EstufaAutomatica-MTI/MTI_EstufaAutomatica/MTI_EstufaAutomatica.ioc

Mcu.UserName=STM32F446RETx
PA0-WKUP.Signal=ADCx_IN0
PA1.Signal=GPIO_Output
PA13.GPIO_Label=TMS
PA13.Signal=SYS_JTMS-SWDIO
PA14.GPIO_Label=TCK
PA14.Signal=SYS_JTCK-SWCLK
PA15.Signal=S_TIM2_CH1_ETR
PA2.GPIO_Label=USART_TX
PA2.Signal=USART2_TX
PA3.GPIO_Label=USART_RX
PA3.Signal=USART2_RX
PA4.Signal=ADCx_IN4
PA5.GPIO_Label=LD2 [Green Led]
PA5.Signal=GPIO_Output
PA7.Signal=ADCx_IN7
PB3.GPIO_Label=SWO
PB3.Signal=SYS_JTDO-SWO
PB7.GPIO_Label=Shutdown
PB7.Signal=GPIO_Output
PC0.GPIO_Label=WaterPump
PC0.Signal=GPIO_Output
PC1.GPIO_Label=PeltierPlate
PC1.Signal=GPIO_Output
PC13.GPIO_Label=B1 [Blue PushButton]
PC13.Signal=GPXTI13
PC14-OSC32_IN.Signal=RCC_OSC32_IN
PC15-OSC32_OUT.Signal=RCC_OSC32_OUT
PC2.GPIO_Label=CoolerFreeze
PC2.Signal=GPIO_Output
PC3.GPIO_Label=CoolerPeltier
PC3.Signal=GPIO_Output
PC6.GPIO_Label=LedRed
PC6.Signal=S_TIM3_CH1
PC8.GPIO_Label=LedGreen
PC8.Signal=S_TIM3_CH3
PC9.GPIO_Label=LedBlue
PC9.Signal=S_TIM3_CH4
PH0-OSC_IN.Signal=RCC_OSC_IN
PH1-OSC_OUT.Signal=RCC_OSC_OUT
