EstufaAutomatica-MTI/MTI_EstufaAutomatica/Core/Inc/main.h

#define B1_Pin GPIO_PIN_13
#define B1_GPIO_Port GPIOC
#define WaterPump_Pin GPIO_PIN_0
#define WaterPump_GPIO_Port GPIOC
#define PeltierPlate_Pin GPIO_PIN_1
#define PeltierPlate_GPIO_Port GPIOC
#define CoolerFreeze_Pin GPIO_PIN_2
#define CoolerFreeze_GPIO_Port GPIOC
#define CoolerPeltier_Pin GPIO_PIN_3
#define CoolerPeltier_GPIO_Port GPIOC
#define USART_TX_Pin GPIO_PIN_2
#define USART_TX_GPIO_Port GPIOA
#define USART_RX_Pin GPIO_PIN_3
#define USART_RX_GPIO_Port GPIOA
#define LD2_Pin GPIO_PIN_5
#define LD2_GPIO_Port GPIOA
#define LedRed_Pin GPIO_PIN_6
#define LedRed_GPIO_Port GPIOC
#define LedGreen_Pin GPIO_PIN_8
#define LedGreen_GPIO_Port GPIOC
#define LedBlue_Pin GPIO_PIN_9
#define LedBlue_GPIO_Port GPIOC
#define TMS_Pin GPIO_PIN_13
#define TMS_GPIO_Port GPIOA
#define TCK_Pin GPIO_PIN_14
#define TCK_GPIO_Port GPIOA
#define SWO_Pin GPIO_PIN_3
#define SWO_GPIO_Port GPIOB
#define Shutdown_Pin GPIO_PIN_7
#define Shutdown_GPIO_Port GPIOB
