EstufaAutomatica-MTI/MTI_EstufaAutomatica/(commit log)

2020-09-07 Criação do projeto
    O projeto da aplicação, que contém o controle dos sensores e atuadores, foi criado no Cube IDE.
2020-09-07 Teste dos sensores
    Inicialmente, foram testados os sensores separadamente. Após isso, uniu-se em um mesmo programa todos os sensores juntos, sendo enviado uma string (foramatada para JSON Object) pela USART para visualização em um programa em NODE-RED.
2020-09-08 Atuadores e comentários
    O código foi comentado, já em sintaxe para doxygen, e foram adicionados os acionamentos da Peltier e Cooler.
    Estamos testando o melhor jeito de receber os controles pela serial.
2020-09-08 USART_RX e correções
    Foi realizada a função que converte os dados enviados pela serial até o ARM, de string para float. Isso permite que o usuario set os parâmetros ideais que ele quiser.
    Além disso, foram trocados os nomes de algumas variáveis e adicionados Defines e Enum pra melhor compreensão do código.
2020-09-09 Outros atuadores
    Foram adicionados os demais atuadores, juntamente com a análise de seus acionamentos.
2020-09-16 Ajustes de temperatura e acionamento da bomba
    Adicionamos controle da bomba de água, timer unico para os atuadores e reorganizamos o acionamento dos coolers e peltier para melhor aproveitamento da temperatura e do consumo de energia.
2020-09-22 Correção de pinagem
    Após construir as placas,fizemos uma alteração na pinagem.
2020-09-22 Ajustes fita de led
    Definimos os pinos do ARM para as 3 cores da fita de led, juntamente com o controle das mesmas e recebimento de dados pela serial.
2020-09-24 Sensor de Corrente
    Realizamos a leitura do sensor de corrente, correção dos atuadores .
2020-09-27 Comentários e potência
    Foram corrigidos os comentários, adicionado o cálculo de potência e adicionado o envio de dados dos atuadores pela USART2.
    [main.c]
2020-10-01 Implementação da lógica de desligamento forçado
    Eliminamos algumas variáveis de StateOf que estavam sendo utilizadas apenas para ajudar a visualizar a lógica. Realizamos a implementação da lógica para um autodesligamento apartir de uma sobre corrente.
2020-10-02 Correção na equação de corrent
    A equação de corrente anterior usava 2047 como marco zero do sensor de corrente (abaixo desse valor é um sentido e acima é o outro sentido da corrente, elevando ou diminuindo). Como o adc do arm usa 3.3V como VREF, colocamos 5V de alimentação no sensor, assim o marco ficará com o valor de 3103 (2,5V), permitindo analisar com maior acuracidade a corrente da fonte (isso somente é válido uma vez que só usaremos um sentido da corrente).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
2020-10-02 Mudanças
    O timer de envio da usart foi alterado de 50s para 5s. O cálculo da corrente foi ajustado para aceitar os diferentes variantes do sensor de corrente.
2020-10-03 Adição do controle dos atuadores
    Foi adicionado o controle de atuação da temperatura, umidade do solo e o controle da fita de led, com formatação para envio da usart.
2020-10-08 Mudança no tamanho do Buffer Rx
    Foi alterado o tamanho do buffer de recebimento da Usart 2, de 31 para 25. Alterado, pois, agora enviarmos números inteiros ao invés de números com ponto flutuante.
2020-10-08 Implementaçao de desligamento e envio do estado da estufa.
    Foi incrementado no Buffer de envio, Tx, o estado da estufa utilizando a variável StateOf[Status]. Também foi adicionado o código que faz o desligamento forçado da estufa.
2020-10-10 Doxygen
    Foi adicionado ao documento o arquivo de Doxygen para documentação das variáveis, funções, etc..
2020-10-10 Correções finais
    Foi adicionado um parâmetro no código do arm para ajustar com maior precisão a corrente elétrica. No node red, os detalhes finais foram feitos, um bug visual que acontecia nas versões anteriores foi corrigido. O doxygen foi atualizado.
    [main.c]
2020-10-12 Update Flow
    Foram adicionados comentários JavaScript em todos os blocos de função e foram usados nós de comentário ao lado de cada etapa do código.
2020-10-15 Ajuste de esquemático
    Ajuste nos valores dos resistores do esquemático.
2020-10-16 Imagens das estufas
    Foram adicionadas fotos de cada uma das estufas, o sistema completo, as placas e as estufas em sí.
2020-10-16 Update Readme.md
    Foram adicionados os textos documentais do projeto, juntamente aos anexos (diagrama, esquema e fotos) e um vídeo demonstrativo do sistema sendo operado por três computadores distintos, afetando todas as estufas conforme planejado. São mostrados no vídeo as lógicas implementadas no projeto, como o uso de histerese nos atuadores, o desligamento de segurança, os códigos de desligamento/religamento pelo usuário, entre outros.
2020-11-22 Imagens requisitadas
    Conforme requistiado pelo professor Zucco, estamos adicionando imagens do dashboard e do flow do Node Red do projeto.
